kirkvolin/UR5e-IIoT-Showcase/operator console/Console_PLC.jpg

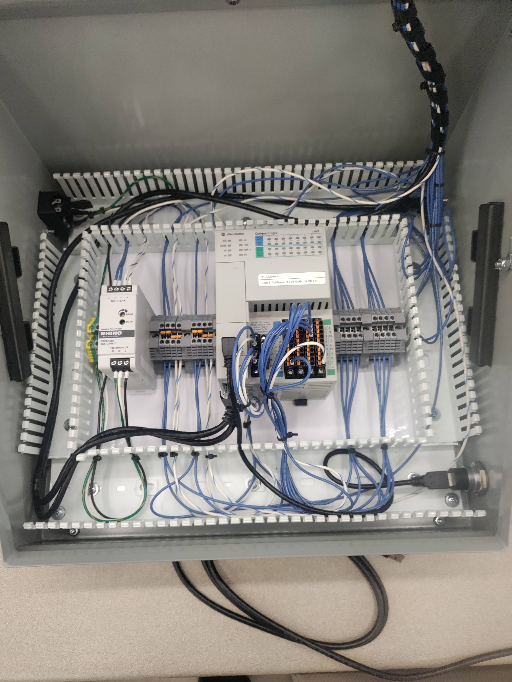
operator console/Console_PLC.jpg
