kirkvolin/UR5e-IIoT-Showcase/operator console/Console_Lid.jpg

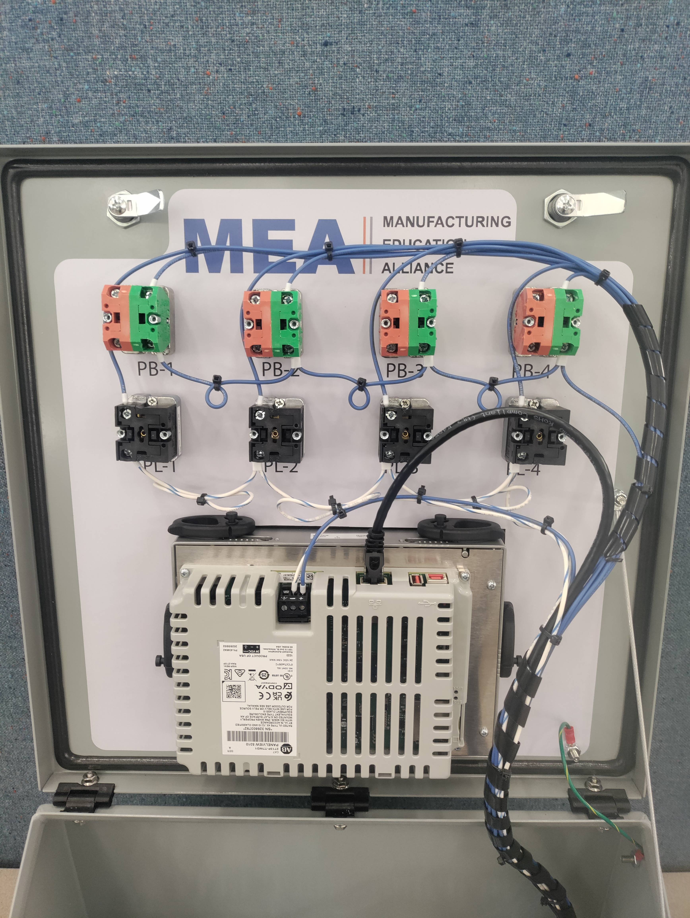
operator console/Console_Lid.jpg
