kirkvolin/UR5e-IIoT-Showcase/cad/Slider.step

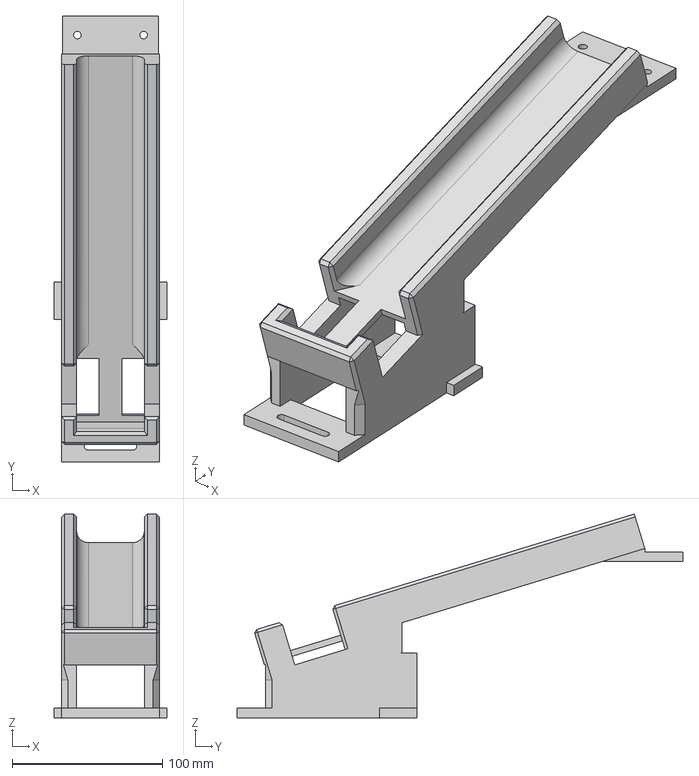
[picture p3: CAD file, 2026-05-02]
cad/Slider.step
75.0 x 297.0 x 135.8 mm
