kirkvolin/UR5e-IIoT-Showcase/cad/1x1_extrusion_endcap.step

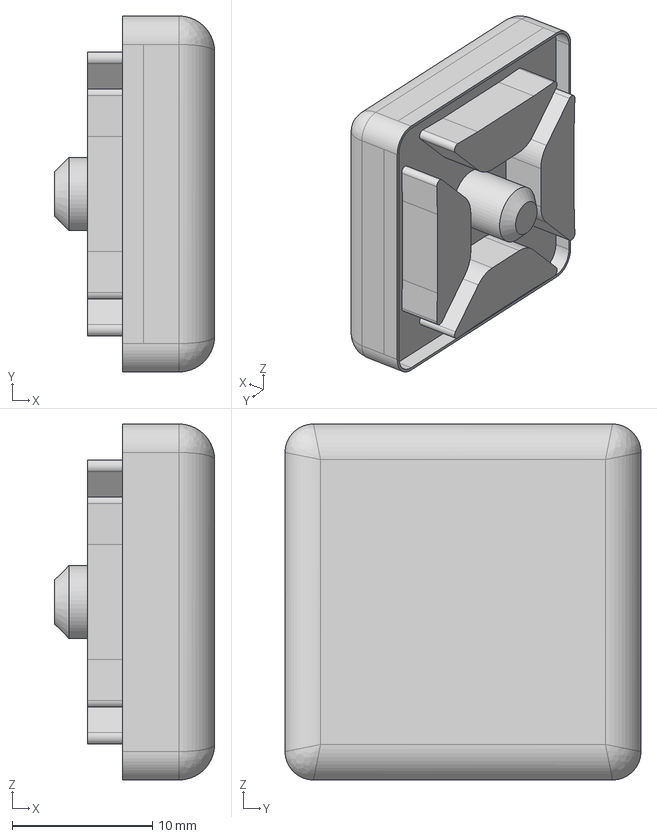
[picture p4: CAD file, 2026-05-02]
cad/1x1_extrusion_endcap.step
11.4 x 25.4 x 25.4 mm
