kirkvolin/UR5e-IIoT-Showcase/cad/Candy Prep Station v1.step

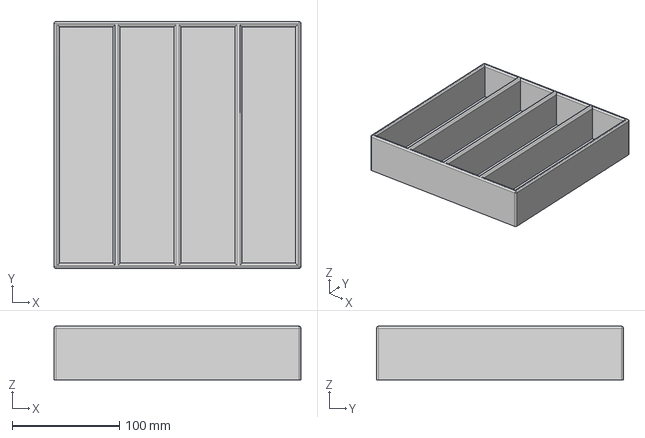
[picture p5: CAD file, 2026-05-02]
cad/Candy Prep Station v1.step
230.0 x 230.0 x 50.0 mm
