kirkvolin/UR5e-IIoT-Showcase/cad/Extrusion Feet.step

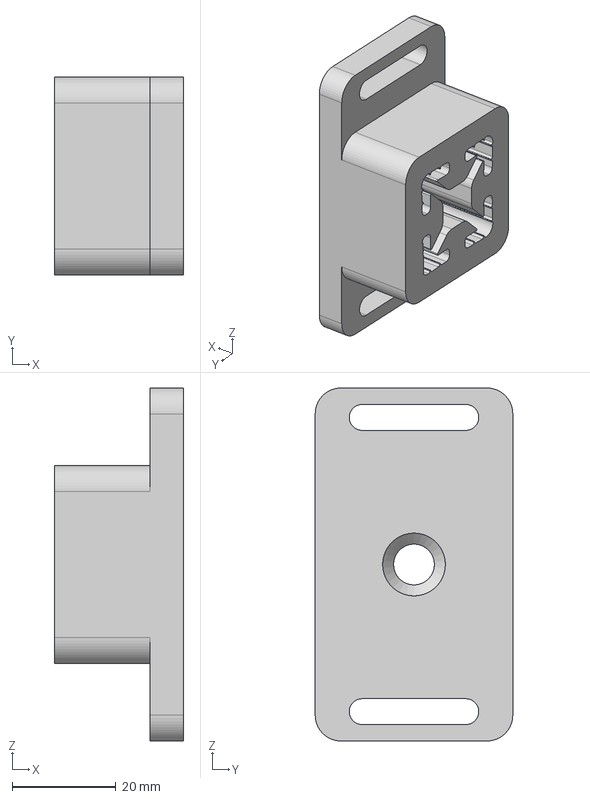
[picture p6: CAD file, 2026-05-02]
cad/Extrusion Feet.step
25.0 x 38.2 x 68.2 mm
